vsenger/Playground4Robotics/PCB Project/Playground4Robotics_Pinout.xlsx

ESP32 Pin | Function
GPIO0 | BOOT Switch (S1)
GPIO1 | TXD (USB)
GPIO2 | External GPIO
GPIO3 | RXD (USB)
GPIO4 | LED 2
GPIO5 | LED 1
GPIO12 | LED 3
GPIO13 | LEFT MOTOR - BAK
GPIO14 | LEFT MOTOR - FOR
GPIO15 | LED 4
GPIO16 | Serial 2 (RX) - (J10 - pin 2)
GPIO17 | Serial 2 (TX) - (J10 - pin 3)
GPIO18 | RIGHT MOTOR - BAK
GPIO19 | RIGHT MOTOR - FOR
GPIO20 | ENCODER (J11 - pin 2)
GPIO21 | I2C (SDA) - (J9 - pin 2)
GPIO22 | I2C (SCL) - (J9 - pin 3)
GPIO23 | USER BUTTON
GPIO25 | ENCODER (J11 - pin 3)
GPIO26 | ADXL345 sensor Interrupt input (optional- must be configured conecting SJ4 or SJ5)
GPIO27 | Sensors and Display Power control (0=Power OFF / 1=Power ON)
GPIO32 | Battery voltage (Analog INPUT)
GPIO33 | (External Analog INPUT)
GPIO34 | (External Analog INPUT)
GPIO35 | (External Analog INPUT)
GPIO36 | (External Analog INPUT)
GPIO39 | External GPIO
