vsenger/Playground4Robotics/PCB Project/datasheets/OLED_display.jpg

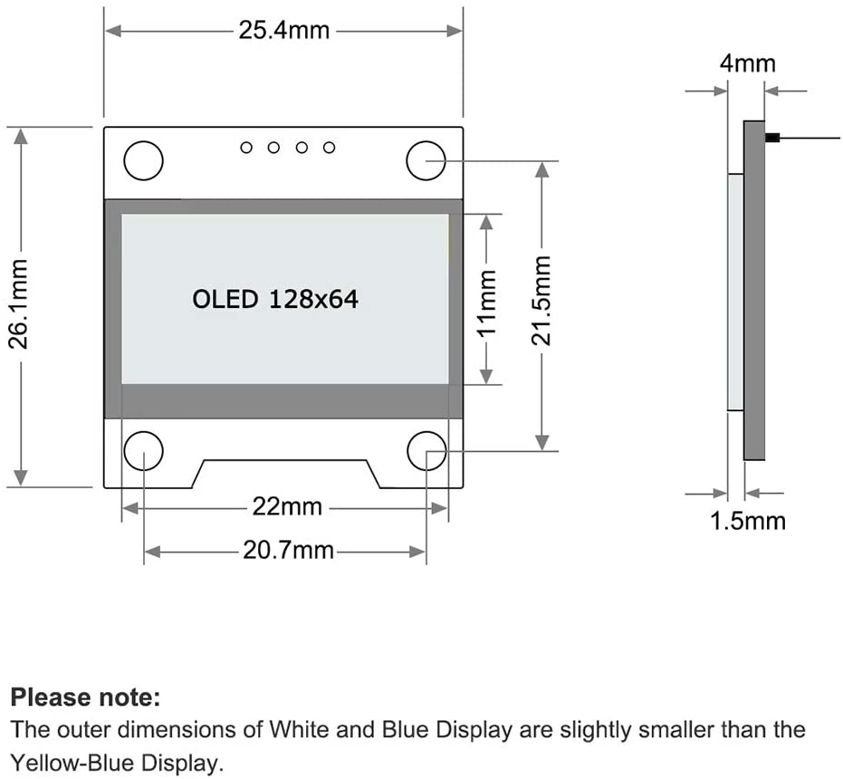
PCB Project/datasheets/OLED_display.jpg
