vsenger/Playground4Robotics/PCB Project/BOM_Board Playground4Robotics_v3.xlsx

Qty | Value | Package | Parts | Description | PART_NUMBER | Unit PRICE (100 PCBs) | SUBTOTAL
6 | 330 | 0805 | R1, R2, R3, R4, R10, R26 | 330 ±1% 1/8W ±100ppm/℃ 0805 Chip Resistor - Surface Mount RoHS | RC0805FR-07330RL | 0.009982 | 0.059892
3 | 10K | 0805 | R5, R9, R23 | 10K ±5% 1/8W ±200ppm/℃ 0805 Chip Resistor - Surface Mount RoHS | CR0805J80103G | 0.002593 | 0.007779
3 | 470 | 0805 | R6, R19, R22 | 470 ±1% 1/8W ±100ppm/℃ 0805 Chip Resistor - Surface Mount RoHS | RC0805FR-07470RL | 0.002803 | 0.008409
2 | 4K7 | 0805 | R7, R8 | 4.7K ±1% 1/8W ±100ppm/℃ 0805 Chip Resistor - Surface Mount RoHS | RCT054K7 FLF | 0.007922 | 0.015844
4 | 191K1% | 0805 | R11, R13, R15, R17 | 191K ±1% 1/8W ±100ppm/℃ 0805 Chip Resistor - Surface Mount RoHS | AC0805FR-07191KL | 0.005412 | 0.021648
4 | 100K1% | 0805 | R12, R16, R14, R18 | 100K ±1% 1/8W ±100ppm/℃ 0805 Chip Resistor - Surface Mount RoHS | RS-05K1003FT | 0.007028 | 0.028112
2 | 12K | 0805 | R20, R21 | 12K ±5% 1/8W ±100ppm/℃ 0805 Chip Resistor - Surface Mount RoHS | AC0805FR-0712KL | 0.001853 | 0.003706
1 | 2.7M1% | 0805 | R24 | 2.7M ±1% 1/8W ±100ppm/℃ 0805 Chip Resistor - Surface Mount RoHS | 0805W8F2704T5E | 0.001825 | 0.001825
1 | 1M1% | 0805 | R25 | 1M ±1% 1/8W ±100ppm/℃ 0805 Chip Resistor - Surface Mount RoHS | RC0805FR-071ML | 0.004152 | 0.004152
7 | 100nf | C0603 | C1, C4, C5, C8, C16, C17, C18 | 100nF ±10% 50V X7R 0603 Multilayer Ceramic Capacitors MLCC - SMD/SMT RoHS | C0603B104K500NT | 0.007856 | 0.054992
1 | 1uF | C0603 | C2 | 1uF ±10% 16V X7R 0603Multilayer Ceramic Capacitors MLCC - SMD/SMT RoHS | CL10A105KO8NNNC | 0.0066 | 0.0066
3 | 2.2uf | C0603 | C3, C9, C14 | 2.2uF ±10% 16V X5R 0603 Multilayer Ceramic Capacitors MLCC - SMD/SMT RoHS | 0603X225K160NT | 0.017376 | 0.052128
1 | 1uF | C0805 | C6 | 1uF ±10% 16V X7R 0805 Multilayer Ceramic Capacitors MLCC - SMD/SMT RoHS | FS21B105K160ECG | 0.03795 | 0.03795
2 | 10uF | AVX-A | C7, C13 | 10uF ±10% 10V 3 Ω @ 100kHz -55℃ ~ +125℃ CASE-A_3216 Tantalum Capacitors RoHS | CA45-A-16V-10uF-K | 0.067255 | 0.13451
2 | 33pF | C0603 | C10, C11 | 33pF ±5% 50V C0G 0603 Multilayer Ceramic Capacitors MLCC - SMD/SMT RoHS | 0603N330F500CT | 0.01484 | 0.02968
2 | 10nf | C0603 | C12, C15 | 10nF ±5% 50V NP0 0603 Multilayer Ceramic Capacitors MLCC - SMD/SMT RoHS | 0603B103J500CT | 0.071798 | 0.143596
1 | 12MHZ | X2-SMD-5.0X3.2X1.3MM | X1 | 12MHz ±30ppm 20pF 150Ω SMD-5032_2P SMD Crystal Resonators RoHS | XSHEELNANF-12MHZ | 0.160606 | 0.160606
4 | green | LED-0603 | LED1, LED2, LED3, LED4 | Green 520~535nm 0603 Light Emitting Diodes (LED) RoHS | 19-217/GHC-YR1S2/3T | 0.035455 | 0.14182
1 | yellow | LED-0603 | LED5 | Yellow 585.5~594.5nm 0603 Light Emitting Diodes (LED) RoHS | 19-217/Y5C-AP1Q2/3T | 0.0020181 | 0.0020181
1 | red | LED-0603 | LED6 | Red 617.5~633.5nm 0603 Light Emitting Diodes (LED) RoHS | 19-217/R6C-AL1M2VY/3T | 0.017727 | 0.017727
1 | SS14 | SMA-DIODE | D1 | SMA Schottky Barrier Diodes (SBD) RoHS | SS14 | 0.009605 | 0.009605
1 | FUSE PTC 1.5 A | 1206 | D2 / F1 | Polymeric 8V 1.5A 200ms 290mΩ 1206 PTC Resettable | 1206L075THYR | 0.034 | 0.034
2 | AP2112 | SOT23-5 | VR1, VR2 | AP2112-3.3v Fixed 6V 3.3V 600mA SOT-25 Low Dropout Regulators(LDO) RoHS | AP2112K-3.3TRG1 | 0.124252 | 0.248504
1 | REG1117 5volts | SOT223 | VR3 | 800mA and 1A Low Dropout (LDO) Positive Regulator 5 volts | AMS1117-5.0 | 0.0376 | 0.0376
1 | ESP-WROOM-03 | ESP-WROOM-03 | U1 | ESP32 Module WIFI Modules RoHS | ESP32-WROOM-32 | 2.615152 | 2.615152
1 | TPS3839 | SOT23-3 | U2 | Simple reset/Power-on reset 1 Push-pull,Totem pole Low effective 2.93V SOT-23(SOT-23-3) PMIC - Supervisors RoHS | TPS3839K33DBZR | 0.39697 | 0.39697
1 | MOTION | LGA-14 | U3 | Analog Devices ADXL345 3-Axis SPI/I2C 2/4/8/16g Accelerometer | ADXL345BCCZ-RL7 | 1.163636 | 1.163636
1 | ATECC608A-SSHDA-B | SOIC127P600X175-8N | U4 | Cryptoathentication ECC608A SOIC | ATECC608A_SSHDA-B | 1.827 | 1.827
1 | CH340G | SO016 | U5 | Transceiver USB 2.0 2Mbps SOP-16_150mil USB ICs RoHS | CH340G | 0.275758 | 0.275758
1 | MAX16054 | SOT23-6 | U6 | TSOT-23-6 Interface - Specialized RoHS | MAX16054AZT+T | 1.204545 | 1.204545
2 | L9110S | SOIC127P600X175-8N | U7, U8 | Motor Drivers SOP-8_150mil RoHS | L9110S | 0.1146 | 0.2292
2 | S8050 | SOT-23 | Q1, Q2 | NPN 500mA 25V 300mW SOT-23 Transistors (NPN/PNP) RoHS | S8050 | 0.007591 | 0.015182
1 | CJ2302 | SOT-23 | Q3 | N Channel 20V 2.1A 1.2V @ 50uA 60 mΩ @ 3.6A,4.5V 350mW SOT-23(SOT-23-3) MOSFET RoHS | CJ2302 S2 | 0.0308 | 0.0308
4 | CONN_17 | 1X17 | J1, J2 | 10P 2.54MM Stackable Long Connector Female Pin Header (Arduino style) | SeeedStudio (320030001) |  | 0
2 | H4P-SMD-2.0 | HW4-SMD-2.0 | J3, J4 | PA SMD Wire To Board / Wire To Wire Connector RoHS | BM04B-PASS-TFT(LF)(SN) | 0.3215 | 0.643
2 | KK | MOLEX-1X2 | J5, J6 | Header Male Pin 0.100"(2.54mm) 2 Through Hole,P=2.54mm Wire To Board / Wire To Wire Connector RoHS | A2543WV-2P | 0.0263 | 0.0526
1 | 10118193-0001LF | MICRO-USB5+6P-SMD-0.65-B | J7 | MICRO-USB-SMD-B-(10118193-0001LF) | (10118193-0001LF) ou (U254-051T-4BH83-F1S) | 0.1442 | 0.1442
1 | 2P-2.0-90D-SMD | HW2-SMD-2.0-90D | J8 | CONN-HEADER-SMD-PH-SIDE-(2P-2.0MM) | S2B-PH-SM4-TB(LF)(SN) | 0.1267 | 0.1267
3 | SM04B-PASS-TBT_LF__SN_ | SM04B-PASS-TBT | J9, J10, J11 | PA Header Male Pin 0.079"(2.00mm) 4 Through Hole,P=2mm Wire To Board / Wire To Wire Connector RoHS | SM04B-PASS-TBT(LF)(SN) | 0.368182 | 1.104546
4 | 1TS002C-2600-4300-CT | 1TS002C26004300CT | S1, S2, S3, S4 | SPST 50mA @ 12VDC Top Actuated Rectangular Button SMD,6x3.5x4.3mm Tactile Switches RoHS | 1TS002C-2400-4300-CT | 0.02936 | 0.11744
1 | DISPLAY-OLED-128X64-I2C | DISPLAY-OLED-128X64-I2C | DISPLAY | 128x64 Dot Matrix OLED Module based on SSD1306 chip | 128x64 oled | 2.1 | 2.1
 | CABLES components
5 | conectors Housing (ANALOG) |  | J3 e J4 (analogs) / J9, J10 e J11 (I2C, Serial and Encoders) | PA 4 0.079"(2.00mm) 1 Male Housing,P=2mm Rectangular Connectors Housings RoHS | PAP-04V-S | 0.0465 | 0.2325
2 | conectors Housing (MOTORS) |  | J5 e J6 (motors) | 2 0.100"(2.54mm) 1 P=2.54mm Rectangular Connectors Housings RoHS | A2543H-2P | 0.0138 | 0.0276
1 | conectors Housing (DC-IN) |  | J8 (DC_IN) | PA 2 0.079"(2.00mm) 1 Male Housing,P=2mm Rectangular Connectors Housings RoHS | PAP-02V-S | 0.0385 | 0.0385
22 | Crimping terminals (ANALOG and DC-IN) |  | J3,J4,J8,J9,J10,J11 (terminals) | Crimping terminal 24~28 0.08~0.21 UL , RoHS , CSA Terminals RoHS | SPHD-002T-P0.5 | 0.0117 | 0.2574
4 | Crimping terminals (MOTORS) |  | J5, J6 (terminals) | Crimping terminal 22~28 RoHS , REACH Terminals RoHS | A2543-TB | 0.0106 | 0.0424
 |  |  |  |  |  | Total | 13.9078321
