vsenger/Playground4Robotics/PCB Project/Invoices_parts/Invoice_battery_Conector_Playground4Robotics_18012021.png

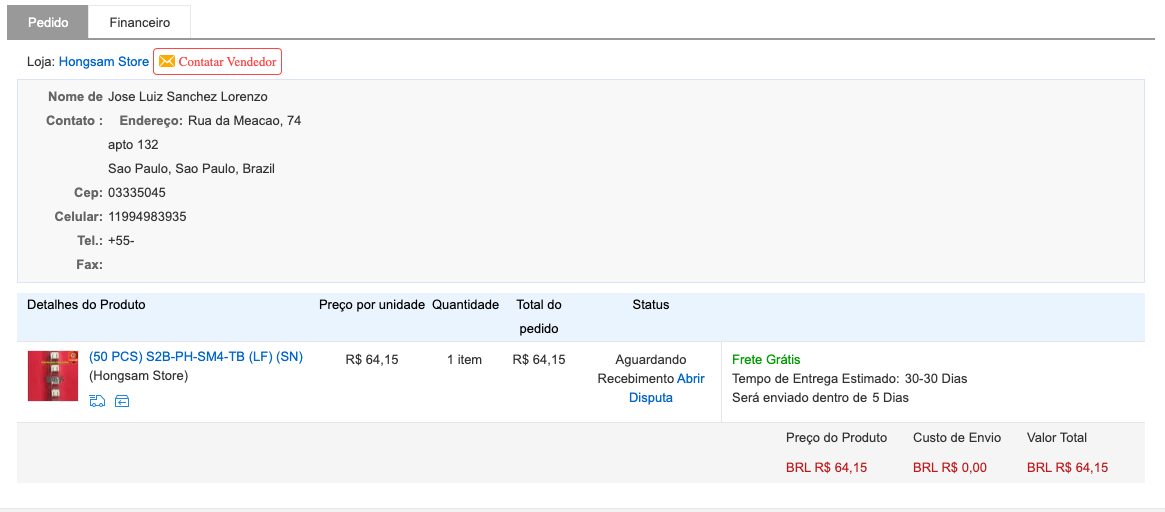
PCB Project/Invoices_parts/Invoice_battery_Conector_Playground4Robotics_18012021.png
