vsenger/Playground4Robotics/PCB Project/Invoices_parts/Invoice_CH340G_playground4Robotics_18012021.png

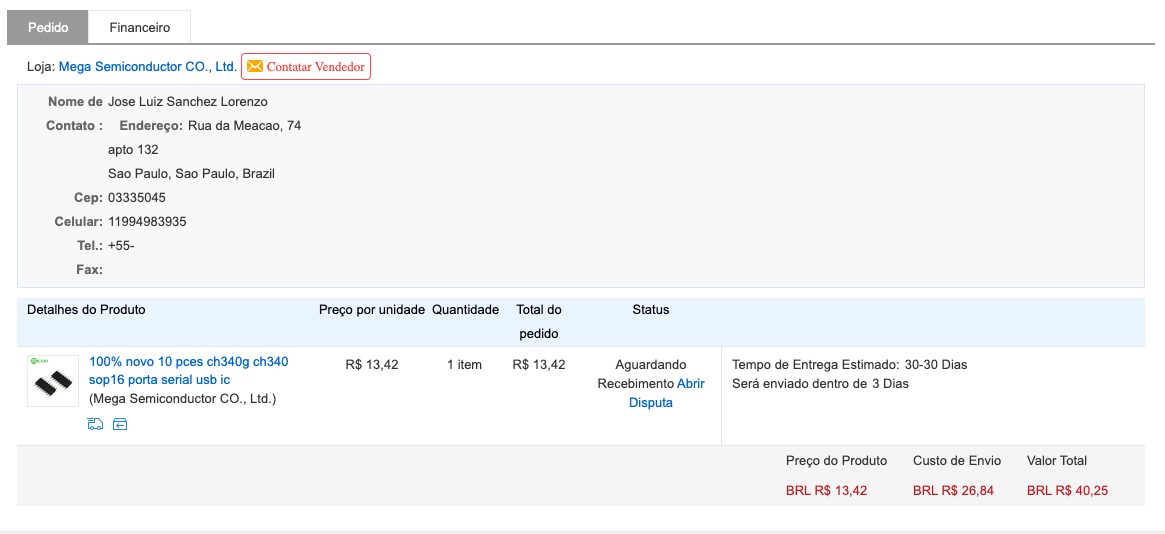
PCB Project/Invoices_parts/Invoice_CH340G_playground4Robotics_18012021.png
