vsenger/Playground4Robotics/PCB Project/Invoices_parts/Invoice_Displays_OLED_Playground4Robotics_15012021.png

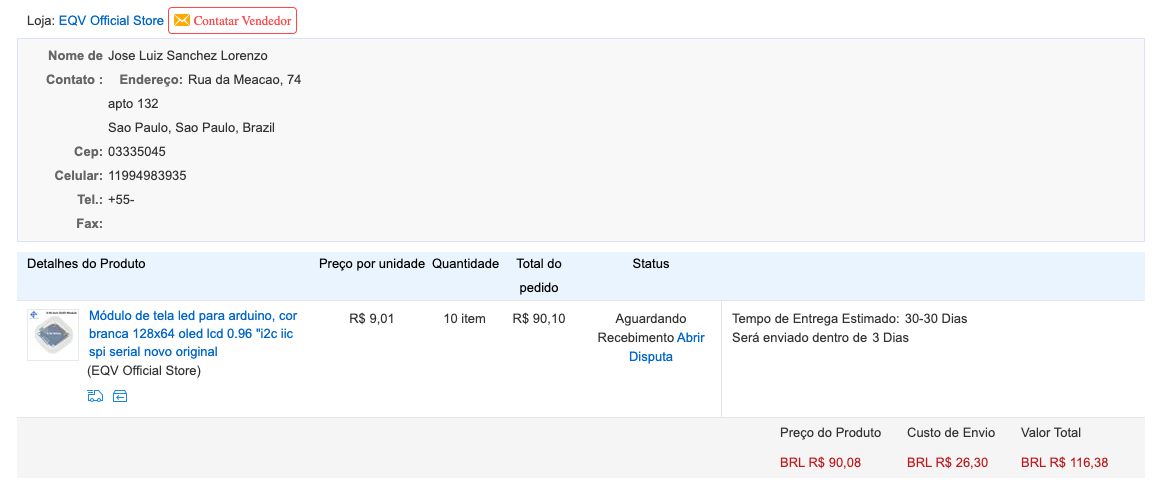
PCB Project/Invoices_parts/Invoice_Displays_OLED_Playground4Robotics_15012021.png
