vsenger/Playground4Robotics/PCB Project/Invoices_parts/invoice_PCBs_Playground4Robotics_28122020.png

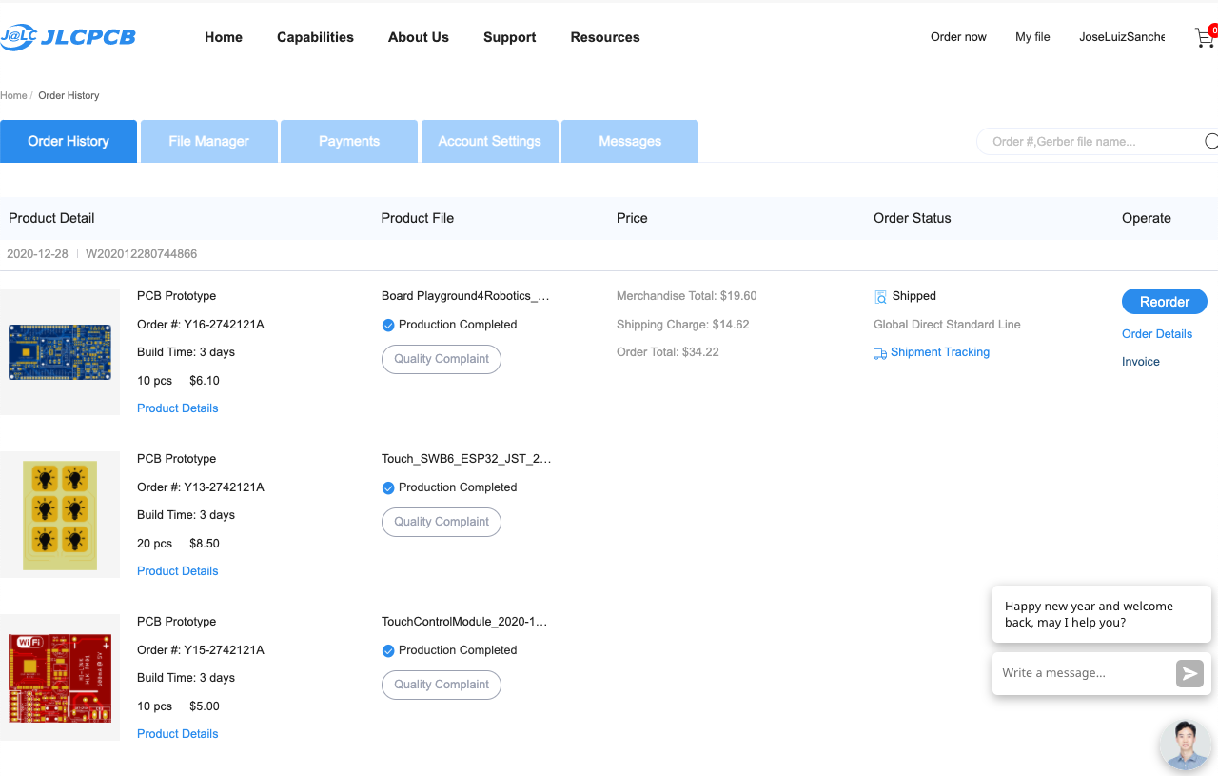
PCB Project/Invoices_parts/invoice_PCBs_Playground4Robotics_28122020.png
