vsenger/Playground4Robotics/(list of files, cad)

Other CAD files:
PCB Project/enclosure_3D_files/Enclosure PlayGround4Robotics v7.f3d
