vsenger/Playground4Robotics/PCB Project/EAGLE_PCB_files/Board Playground4Robotics_V3_Assembly_BOTTOM.pdf

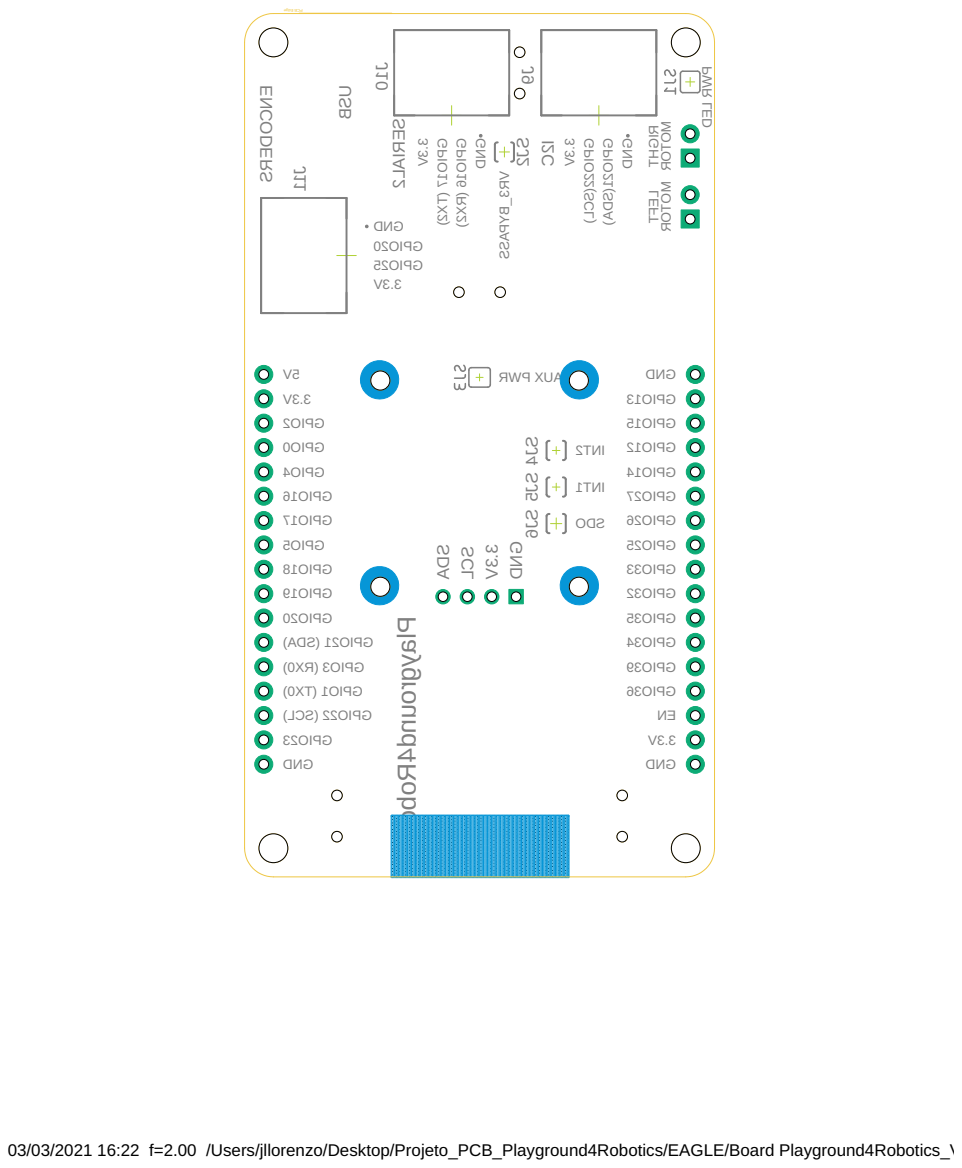
[picture p6: page 1]

03/03/2021 16:22 f=2.00 /Users/jllorenzo/Desktop/Projeto_PCB_Playground4Robotics/EAGLE/Board Playground4Robotics_V3.brd
