vsenger/Playground4Robotics/PCB Project/EAGLE_PCB_files/Board Playground4Robotics_V3_Assembly_TOP.pdf

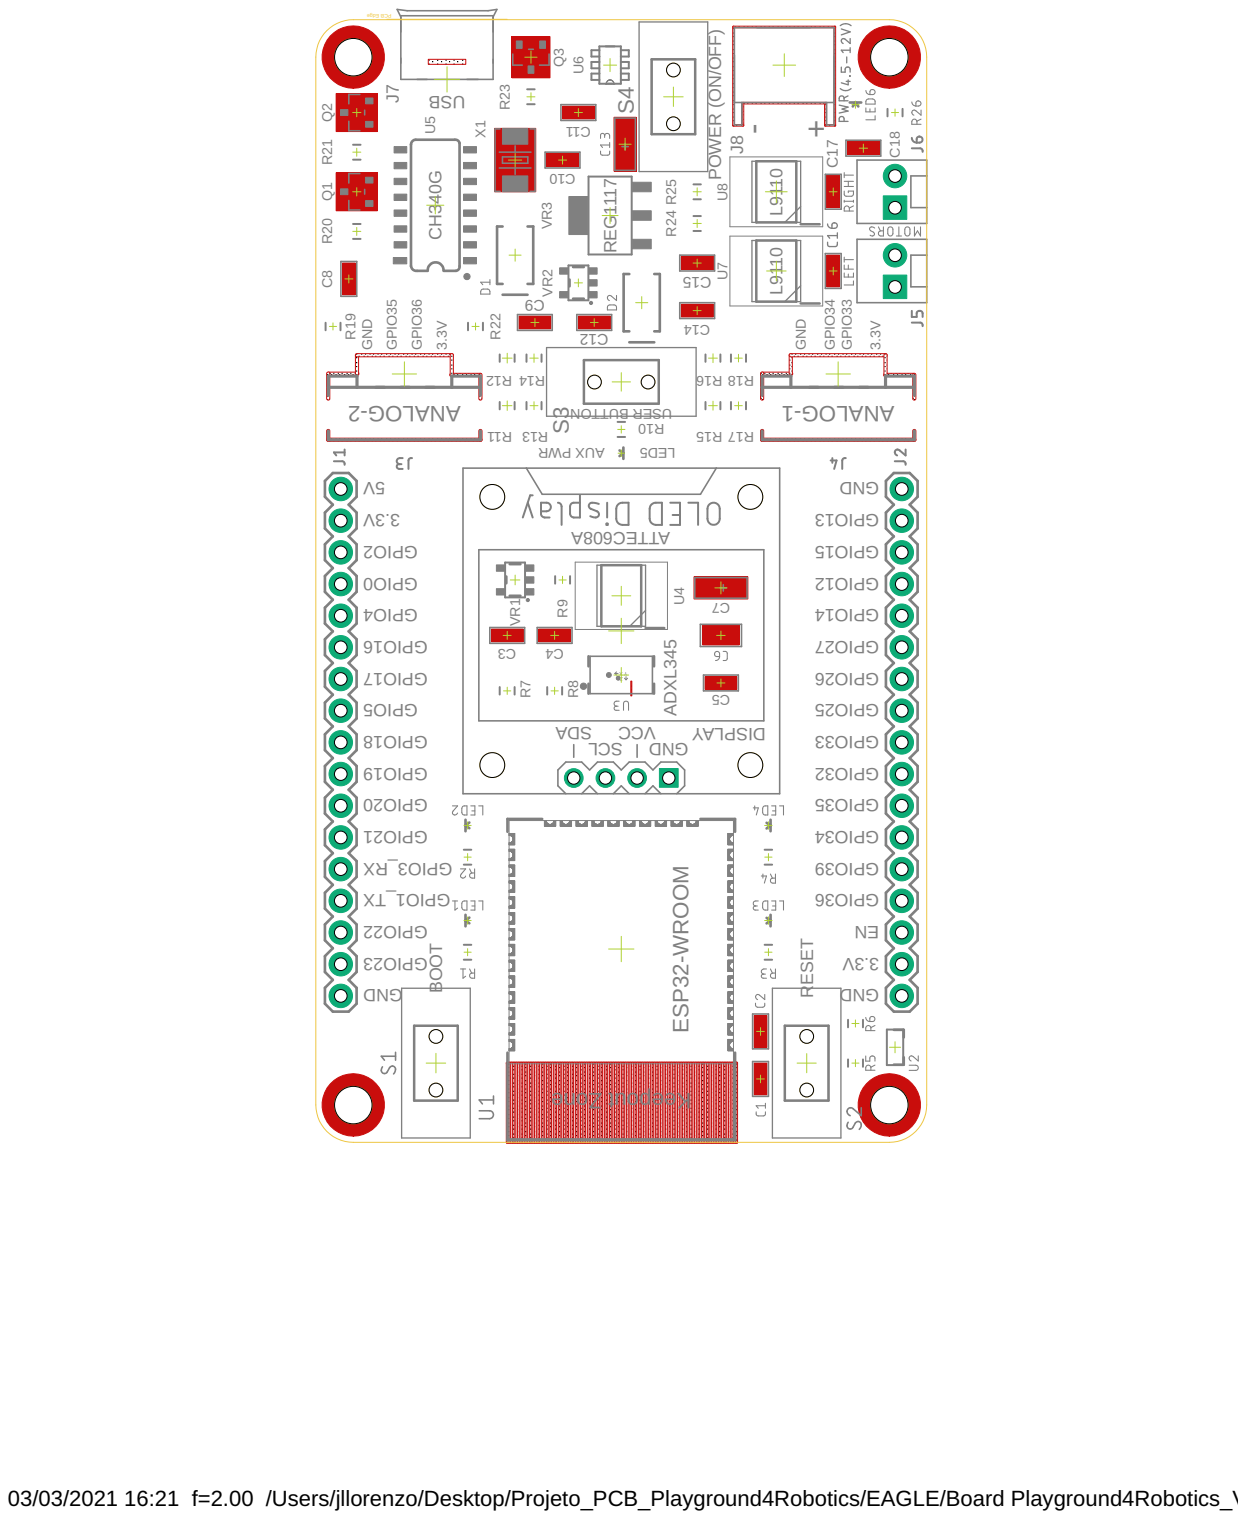
[picture p7: page 1]

03/03/2021 16:21 f=2.00 /Users/jllorenzo/Desktop/Projeto_PCB_Playground4Robotics/EAGLE/Board Playground4Robotics_V3.brd
