vsenger/Playground4Robotics/PCB Project/EAGLE_PCB_files/Board Playground4Robotics_V3_BRD_BOTTOM.pdf

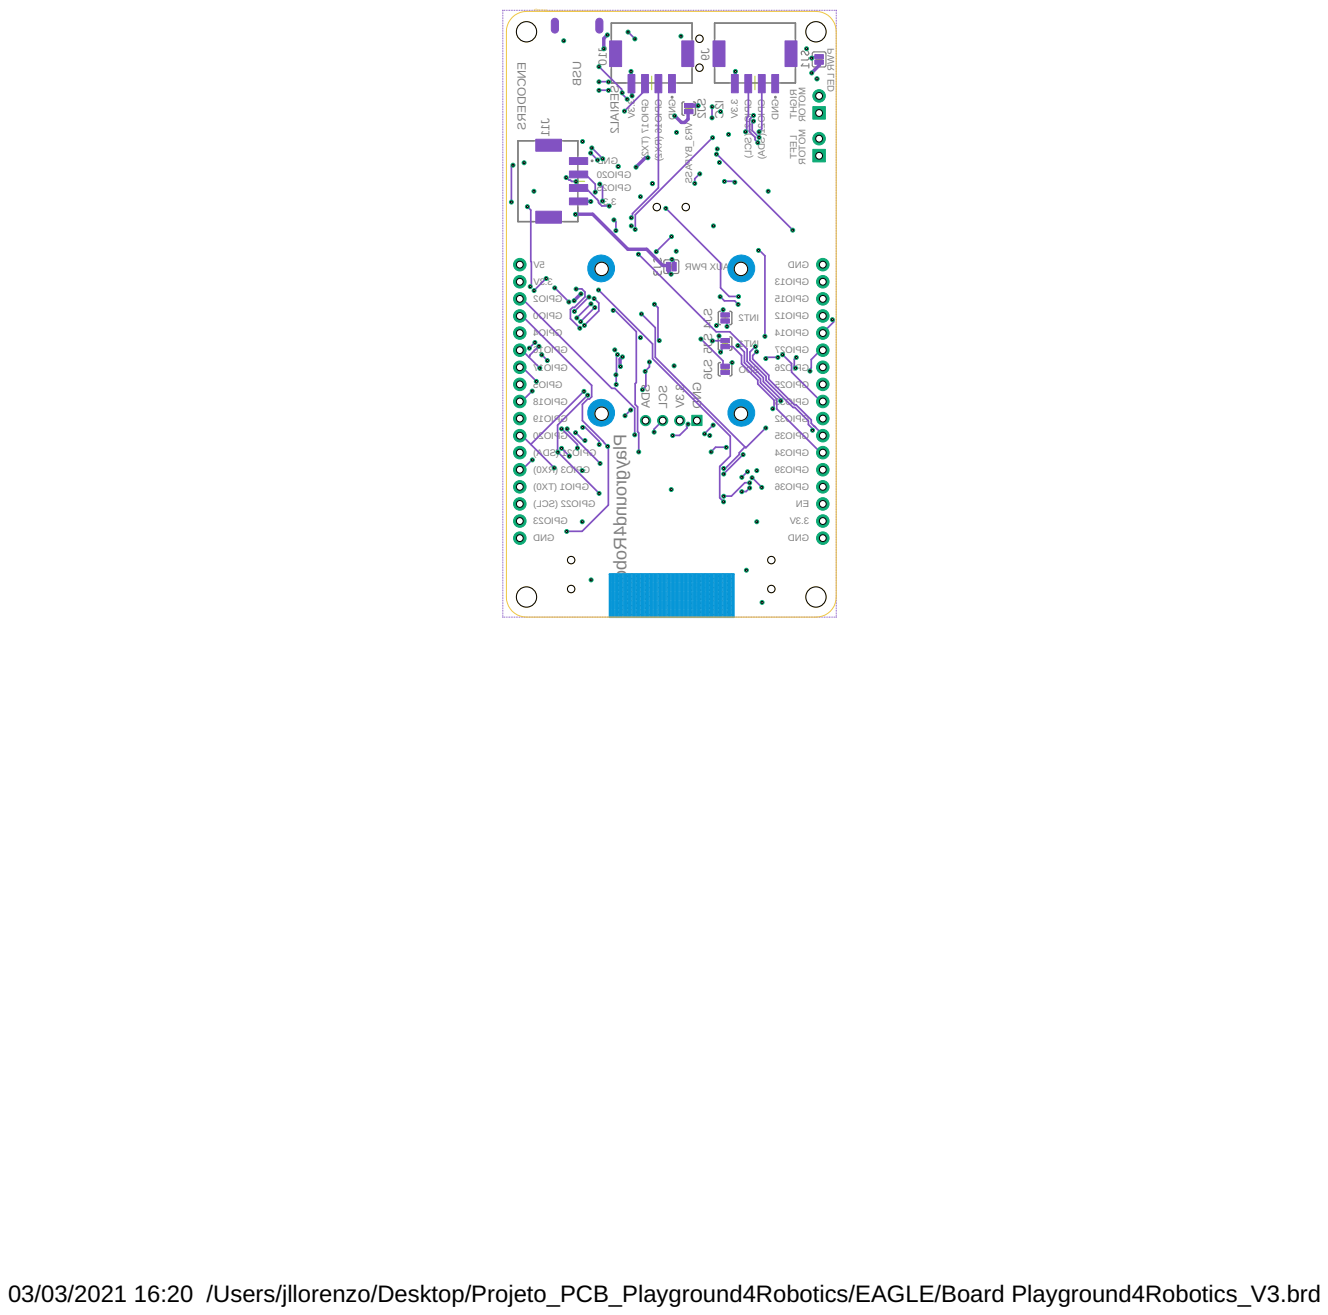
[picture p8: page 1]

LEFT RIGHT MOTOR MOTOR

03/03/2021 16:20 /Users/jllorenzo/Desktop/Projeto_PCB_Playground4Robotics/EAGLE/Board Playground4Robotics_V3.brd
