vsenger/Playground4Robotics/PCB Project/EAGLE_PCB_files/Board Playground4Robotics_V3_SCH.pdf

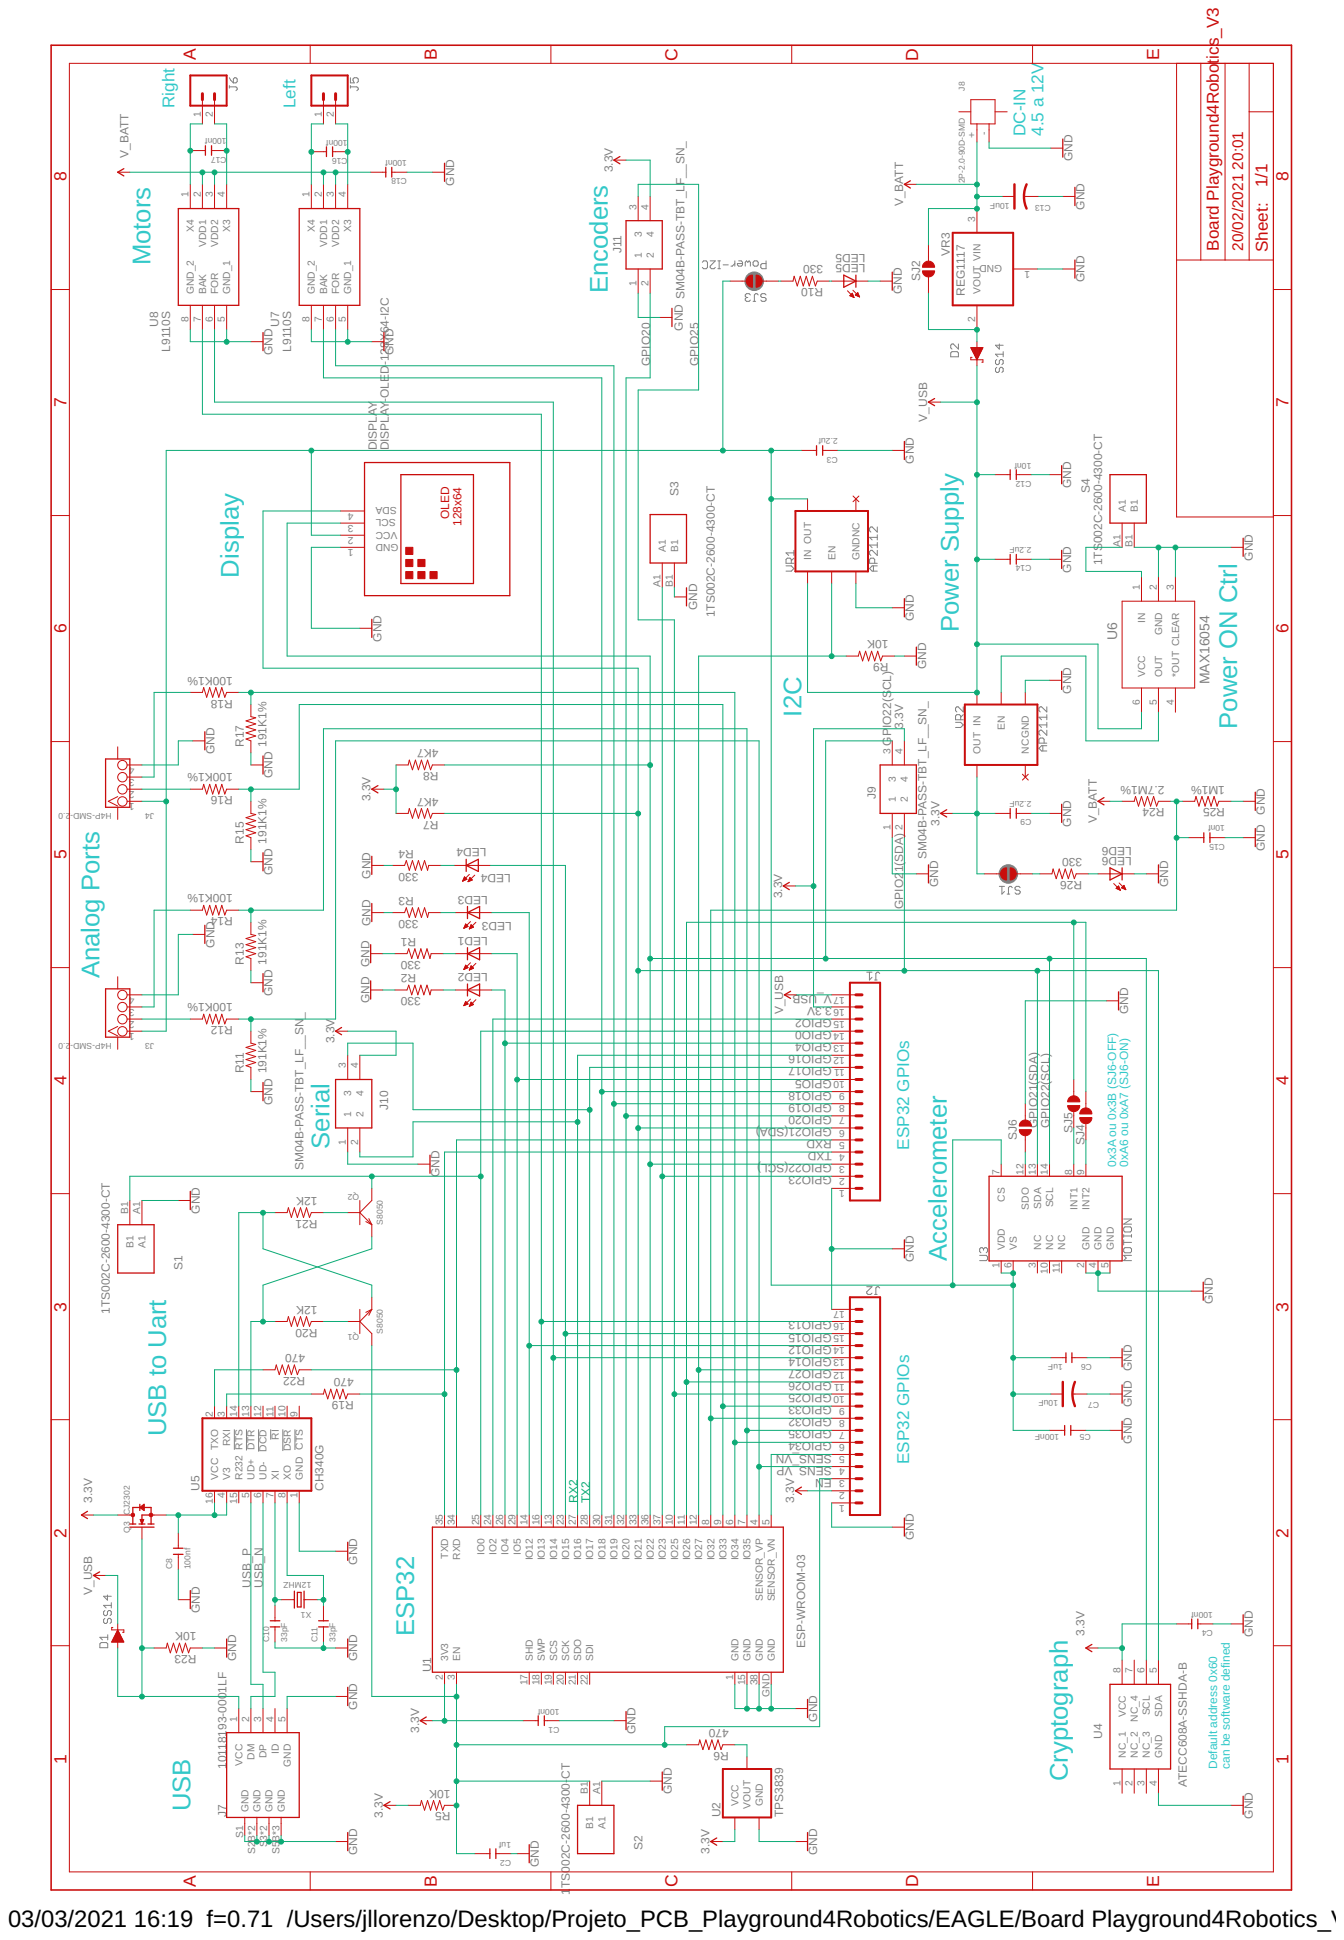
[picture p10: page 1]

IN GND OUT EN

0x3A ou 0x3B (SJ6-OFF) 0xA6 ou 0xA7 (SJ6-ON) P

GND GND

can be software defined

03/03/2021 16:19 f=0.71 /Users/jllorenzo/Desktop/Projeto_PCB_Playground4Robotics/EAGLE/Board Playground4Robotics_V3.sch (Sheet: 1/1)
