vsenger/Playground4Robotics/PCB Project/EAGLE_PCB_files/Board Playground4Robotics_V3.brd

## EAGLE design PCB Project/EAGLE_PCB_files/Board Playground4Robotics_V3.brd (2021-03-04)

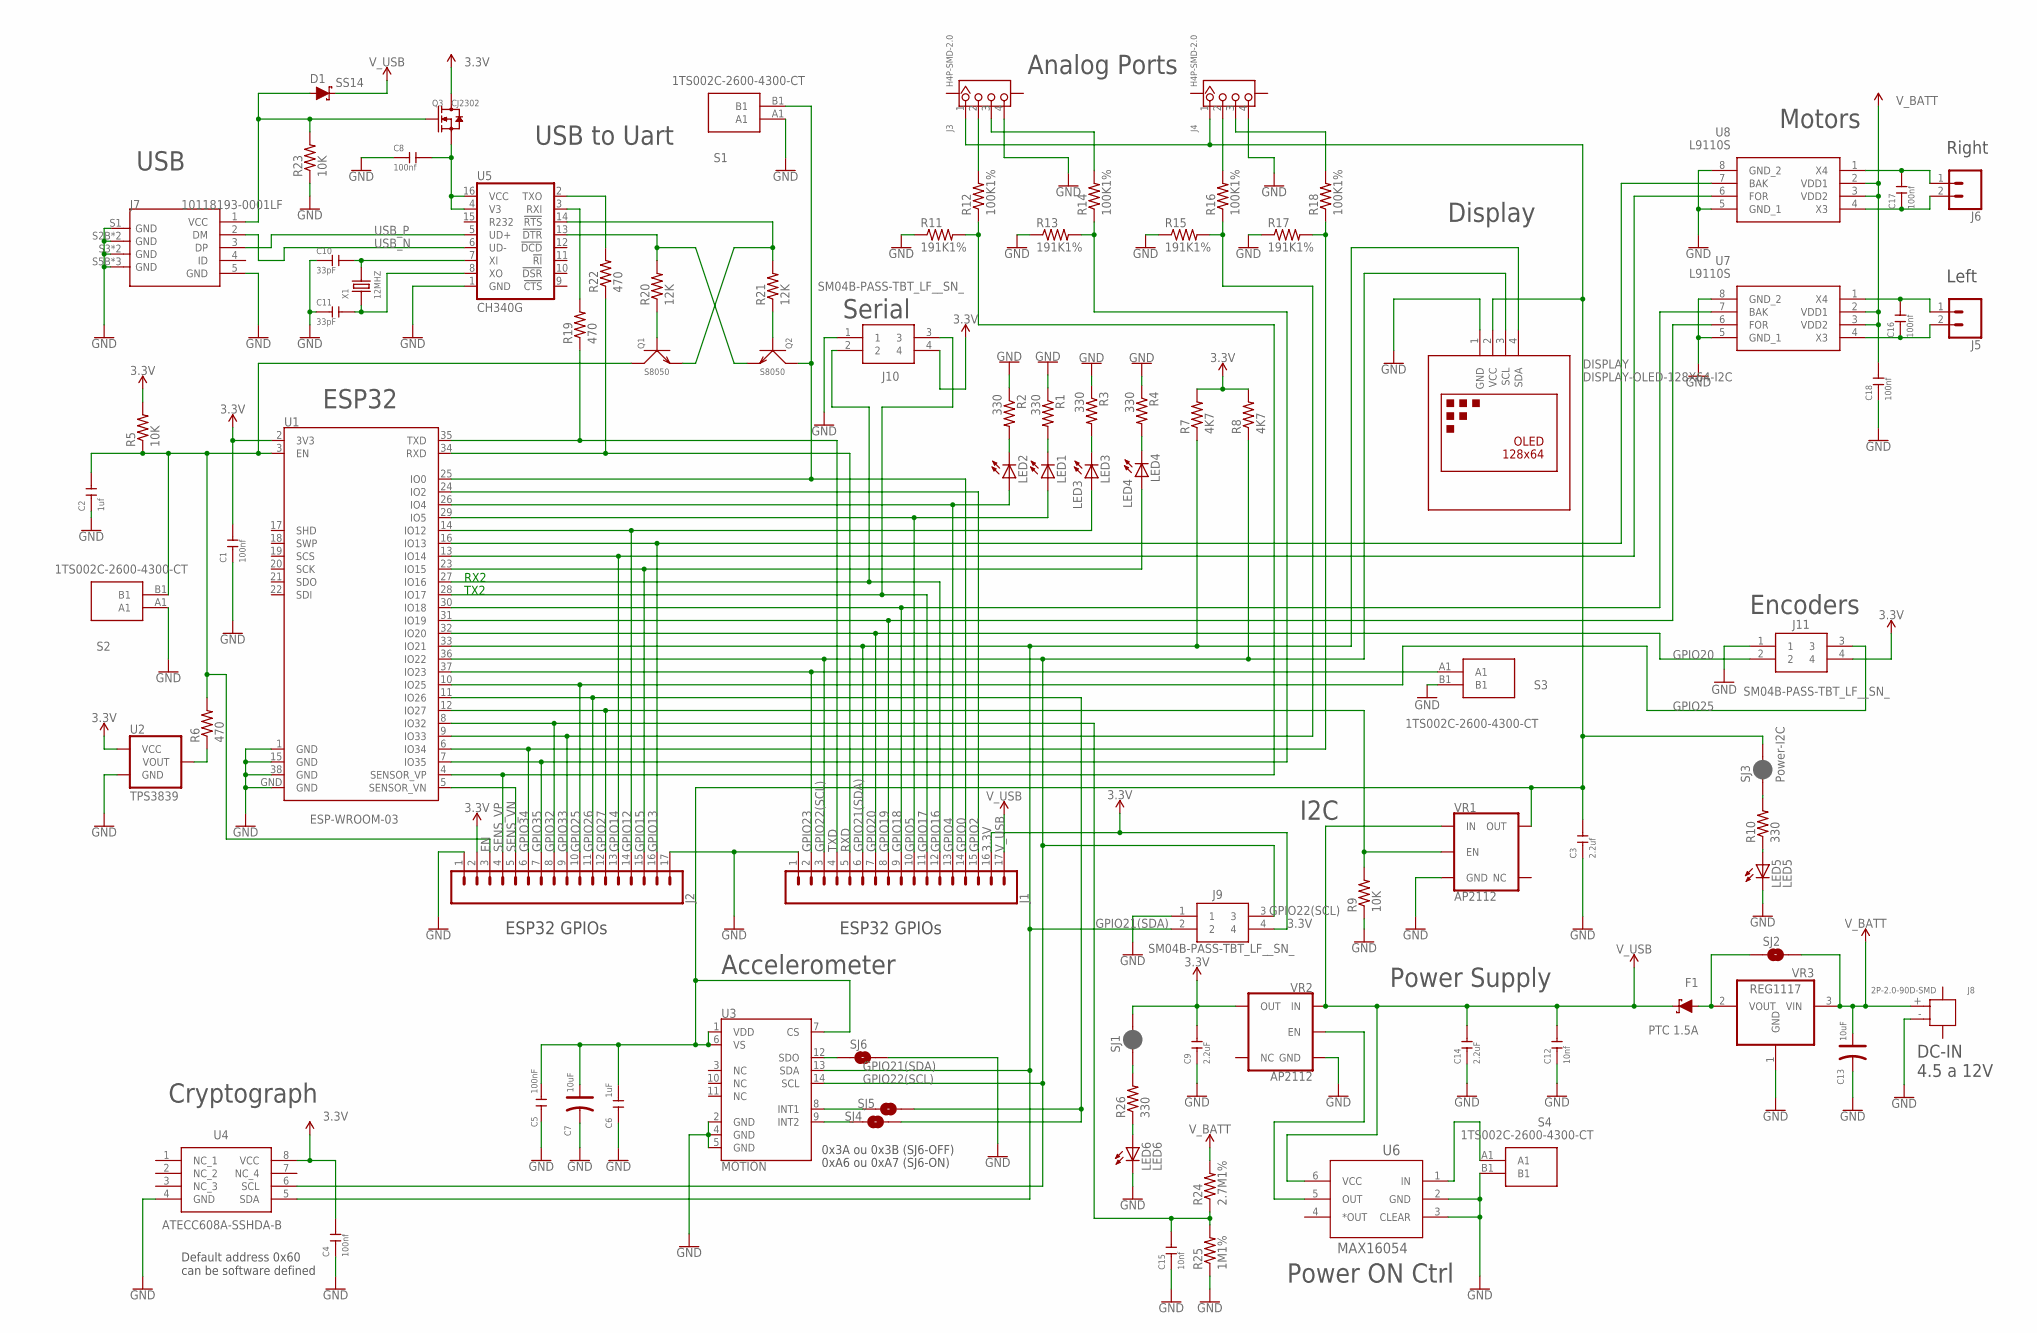
[picture p11: schematic Board Playground4Robotics_V3.sch]

Parts:
C1, C4, C8, C16, C17, C18: 100nf; C0603
C2: 1uf; C0603
C3: 2.2uf; C0603
C5: 100nF; C0603
C6: 1uF; C0805
C7, C13: 10uF; AVX-A
C9, C14: 2.2uF; C0603
C10, C11: 33pF; C0603
C12, C15: 10nf; C0603
D1: SS14; SMA-DIODE
DISPLAY: DISPLAY-OLED-128X64-I2C
F1: PTC 1.5A; SMA-DIODE
J1, J2: CONN_17; 1X17
J3, J4: H4P-SMD-2.0; HW4-SMD-2.0
J5, J6: CONN_02POLAR; MOLEX-1X2
J7: 10118193-0001LF; MICRO-USB5+6P-SMD-0.65-B
J8: 2P-2.0-90D-SMD; HW2-SMD-2.0-90D
J9, J10, J11: SM04B-PASS-TBT_LF__SN_; SM04B-PASS-TBT
LED1: LED1; LED-0603
LED2: LED2; LED-0603
LED3: LED3; LED-0603
LED4: LED4; LED-0603
LED5: LED5; LED-0603
LED6: LED6; LED-0603
Q1, Q2: S8050; SOT-23
Q3: CJ2302; SOT-23
R1, R2, R3, R4, R10, R26: 330; 0805
R5, R9, R23: 10K; 0805
R6, R19, R22: 470; 0805
R7, R8: 4K7; 0805
R11, R13, R15, R17: 191K1%; 0805
R12, R14, R16, R18: 100K1%; 0805
R20, R21: 12K; 0805
R24: 2.7M1%; 0805
R25: 1M1%; 0805
S1, S2, S3, S4: 1TS002C-2600-4300-CT; 1TS002C26004300CT
SJ1: Power-Led; SMT-JUMPER_2_NC_PASTE_SILK
SJ2, SJ6: ADXL_ADDRESS; SJ_2S-NO
SJ3: Power-I2C; SMT-JUMPER_2_NC_PASTE_SILK
SJ4, SJ5: INT1; SJ_2S-NO
U1: ESP-WROOM-03
U2: TPS3839; SOT23-3
U3: MOTION; LGA-14
U4: ATECC608A-SSHDA-B; SOIC127P600X175-8N
U5: CH340G; SO016
U6: MAX16054; SOT23-6
U7, U8: L9110S; SOIC127P600X175-8N
VR1, VR2: AP2112; SOT23-5
VR3: REG1117; SOT223
X1: 12MHZ; X2-SMD-5.0X3.2X1.3MM

Connections:
3.3V: C1.2, C4.2, C9.2, J1.16, J2.2, J9.4, J10.4, J11.4, Q3.3 (D), R5.2, R7.2, R8.2, SJ1.2, U1.2 (3V3), U2.3 (VCC), U4.8 (VCC), VR2.5 (OUT)
EN: C2.2, J2.3, Q1.3 (C), R5.1, R6.2, S2.B1, U1.3 (EN)
GND: C1.1, C2.1, C3.1, C4.1, C5.1, C6.2, C7.-, C8.1, C9.1, C10.1, C11.1, C12.1, C13.-, C14.1, C15.1, C18.1, DISPLAY.1 (GND), J1.1, J2.1, J2.17, J3.4, J4.4, J7.5 (GND), J7.S1 (GND), J7.S2B (GND), J7.S2T (GND), J7.S3 (GND), J7.S4 (GND), J7.S5B (GND), J7.S5T (GND), J7.S6 (GND), J8.- (2), J9.1, J10.1, J11.1, LED5.C, LED6.C, R1.1, R2.1, R3.1, R4.1, R9.1, R11.1, R13.1, R15.1, R17.1, R23.1, R25.1, S1.A1, S2.A1, S3.B1, S4.B1, SJ6.2, U1.1 (GND), U1.15 (GND), U1.38 (GND), U1.GND, U2.1 (GND), U3.2 (GND), U3.4 (GND), U3.5 (GND), U4.4 (GND), U5.1 (GND), U6.2 (GND), U6.3 (CLEAR), U7.5 (GND_1), U7.8 (GND_2), U8.5 (GND_1), U8.8 (GND_2), VR1.2 (GND), VR2.2 (GND), VR3.1 (GND)
GPIO0: J1.14, Q2.3 (C), S1.B1, U1.25 (IO0)
GPIO2: J1.15, U1.24 (IO2)
GPIO4: J1.13, LED2.A, U1.26 (IO4)
GPIO5: J1.10, LED1.A, U1.29 (IO5)
GPIO12: J2.14, LED3.A, U1.14 (IO12)
GPIO13: J2.16, U1.16 (IO13), U8.7 (BAK)
GPIO14: J2.13, U1.13 (IO14), U8.6 (FOR)
GPIO15: J2.15, LED4.A, U1.23 (IO15)
GPIO16: J1.12, J10.2, U1.27 (IO16)
GPIO17: J1.11, J10.3, U1.28 (IO17)
GPIO18: J1.9, U1.30 (IO18), U7.7 (BAK)
GPIO19: J1.8, U1.31 (IO19), U7.6 (FOR)
GPIO20: J1.7, J11.2, U1.32 (IO20)
GPIO21(SDA): DISPLAY.4 (SDA), J1.6, J9.2, R7.1, U1.33 (IO21), U3.13 (SDA), U4.5 (SDA)
GPIO22(SCL): DISPLAY.3 (SCL), J1.3, J9.3, R8.1, U1.36 (IO22), U3.14 (SCL), U4.6 (SCL)
GPIO23: J1.2, S3.A1, U1.37 (IO23)
GPIO25: J2.10, J11.3, U1.10 (IO25)
GPIO26: J2.11, SJ4.2, SJ5.2, U1.11 (IO26)
GPIO27: J2.12, R9.2, U1.12 (IO27), VR1.3 (EN)
GPIO32: C15.2, J2.8, R24.1, R25.2, U1.8 (IO32)
GPIO33: J2.9, R15.2, R16.1, U1.9 (IO33)
GPIO34: J2.6, R17.2, R18.1, U1.6 (IO34)
GPIO35: J2.7, R13.2, R14.1, U1.7 (IO35)
unnamed: D1.A, J7.1 (VCC), Q3.1 (G), R23.2
unnamed: C17.2, J6.1, U8.1 (X4)
unnamed: R6.1, U2.2 (VOUT)
unnamed: J3.2, R12.2
unnamed: SJ5.1, U3.8 (INT1)
unnamed: SJ4.1, U3.9 (INT2)
unnamed: C8.2, Q3.2 (S), U5.4 (V3), U5.16 (VCC)
unnamed: S4.A1, U6.1 (IN)
unnamed: C10.2, U5.7 (XI), X1.2
unnamed: U6.5 (OUT), VR2.3 (EN)
unnamed: Q1.1 (B), R20.1
unnamed: C11.2, U5.8 (XO), X1.1
unnamed: SJ6.1, U3.12 (SDO)
unnamed: C17.1, J6.2, U8.4 (X3)
unnamed: C16.2, J5.1, U7.1 (X4)
unnamed: C16.1, J5.2, U7.4 (X3)
unnamed: J3.3, R14.2
unnamed: Q2.1 (B), R21.1
unnamed: F1.A, SJ2.1, VR3.2 (VOUT)
unnamed: LED2.C, R2.2
unnamed: LED1.C, R1.2
unnamed: Q1.2 (E), R21.2, U5.14 (!RTS)
unnamed: LED4.C, R4.2
unnamed: LED3.C, R3.2
unnamed: Q2.2 (E), R20.2, U5.13 (!DTR)
unnamed: J4.2, R16.2
unnamed: J4.3, R18.2
unnamed: C3.2, C5.2, C6.1, C7.+, DISPLAY.2 (VCC), J3.1, J4.1, SJ3.2, U3.1 (VDD), U3.6 (VS), U3.7 (CS), VR1.5 (OUT)
unnamed: R19.2, U5.3 (RXI)
unnamed: R22.2, U5.2 (TXO)
unnamed: LED6.A, R26.1
unnamed: R26.2, SJ1.1
unnamed: LED5.A, R10.1
unnamed: R10.2, SJ3.1
RXD: J1.5, R22.1, U1.34 (RXD)
SENS_VN: J2.5, U1.5 (SENSOR_VN)
SENS_VP: J2.4, R11.2, R12.1, U1.4 (SENSOR_VP)
TXD: J1.4, R19.1, U1.35 (TXD)
USB_N: J7.2 (DM), U5.6 (UD-)
USB_P: J7.3 (DP), U5.5 (UD+)
V_BATT: C13.+, C18.2, J8.+ (1), R24.2, SJ2.2, U7.2 (VDD1), U7.3 (VDD2), U8.2 (VDD1), U8.3 (VDD2), VR3.3 (VIN)
V_USB: C12.2, C14.2, D1.C, F1.C, J1.17, U6.6 (VCC), VR1.1 (IN), VR2.1 (IN)

Notes on the sheet:
USB
I2C
Accelerometer
Default address 0x60 can be software defined
Serial
ESP32
Power Supply
USB to Uart
Analog Ports
ESP32 GPIOs
RX2
TX2
Display
0x3A ou 0x3B (SJ6-OFF)
0xA6 ou 0xA7 (SJ6-ON)
Power ON Ctrl
Cryptograph
Encoders
Motors
Left
Right
DC-IN 4.5 a 12V

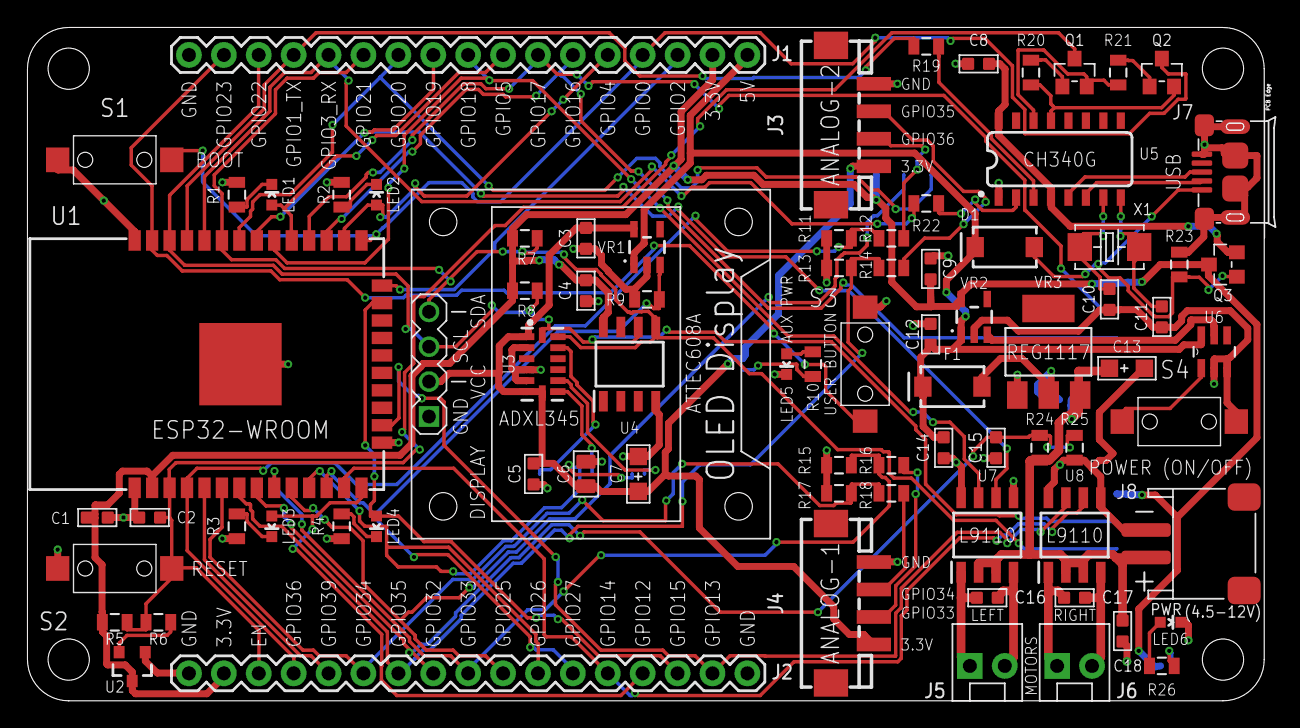
[picture p12: board Board Playground4Robotics_V3.brd from above]

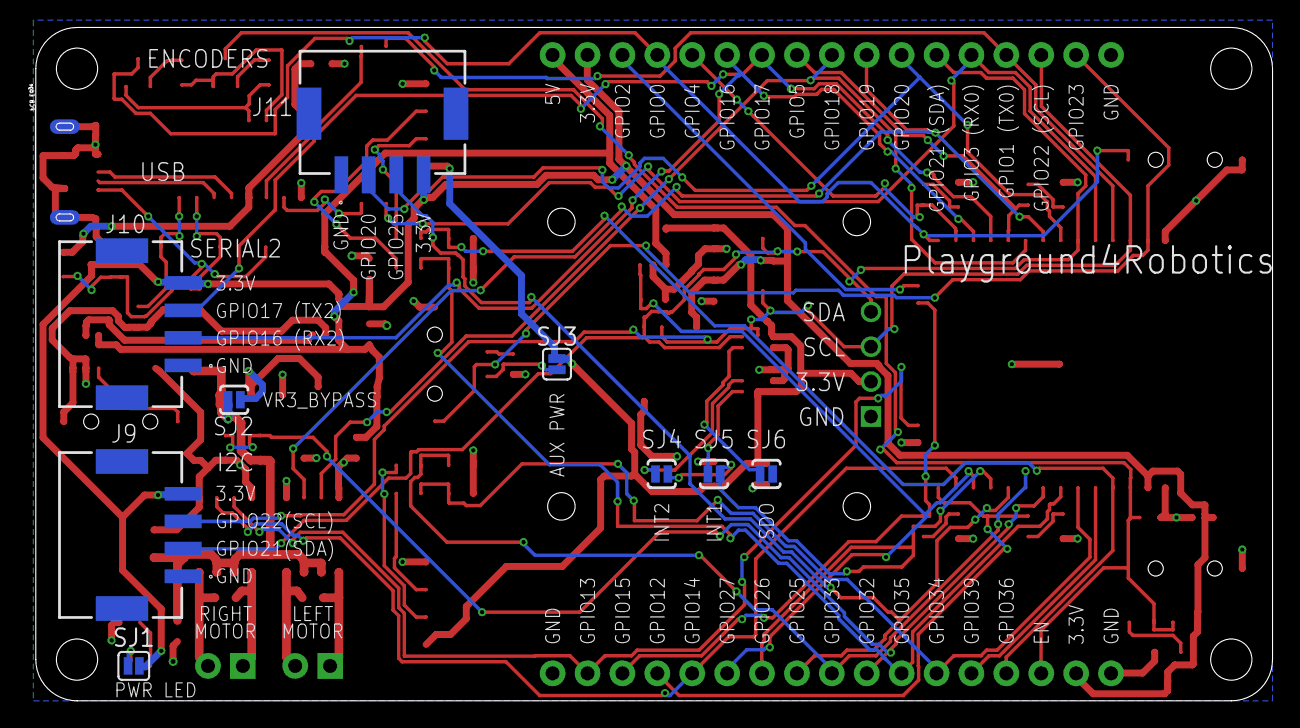
[picture p13: board Board Playground4Robotics_V3.brd from below]

Board: 2 copper layers, 90.0 x 49.0 mm, 89 parts (9 on the bottom side), 68 nets.
