vsenger/Playground4Robotics/PCB Project/Firmware/PCB_Playground4Robotics_demo_v1/Check_ATTEC608.ino

void checkAttec608(){
  if (atecc.begin() == true)
  {
    Serial.println("Successful wakeUp(). I2C connections are good.");
  }
  else
  {
    Serial.println("Device not found. Check wiring.");
  }
}
